Rocco83/esphome-light-controller/hardware/feedback-breakout/README.md

This board has been never produced
Date: 20261022
