Rocco83/esphome-light-controller/hardware/feedback-breakout-smd/jlcpbc-202610/bom.csv

Designator | Footprint | Quantity | Value | LCSC Part #
C1, C10, C11, C12, C13, C14, C15, C16, C2, C3, C4, C5, C6, C7, C8, C9 | 0805 | 16 | 10nF | C1710
D1, D10, D11, D12, D13, D14, D15, D16, D2, D3, D4, D5, D6, D7, D8, D9 | 0805 | 16 | GREEN | C2297
JINA | PinHeader_1x10_P2.54mm_Vertical | 1 | IN-A
JINB | PinHeader_1x10_P2.54mm_Vertical | 1 | IN-B
JOUTA | PinHeader_1x10_P2.54mm_Vertical | 1 | OUT-A
JOUTB | PinHeader_1x10_P2.54mm_Vertical | 1 | OUT-B
Q1, Q10, Q11, Q12, Q13, Q14, Q15, Q16, Q2, Q3, Q4, Q5, Q6, Q7, Q8, Q9 | SOT-23 | 16 | BC817-40 | C8589
R1, R10, R11, R12, R13, R14, R15, R16, R2, R3, R4, R5, R6, R7, R8, R9, RB1, RB10, RB11, RB12, RB13, RB14, RB15, RB16, RB2, RB3, RB4, RB5, RB6, RB7, RB8, RB9 | 0805 | 32 | 100k | C149504
RE1, RE10, RE11, RE12, RE13, RE14, RE15, RE16, RE2, RE3, RE4, RE5, RE6, RE7, RE8, RE9 | 0805 | 16 | 1k | C17513
