Rocco83/esphome-light-controller/hardware/feedback-breakout/feedback-breakout.kicad_pcb

## KiCad design hardware/feedback-breakout/feedback-breakout.kicad_pcb (2026-10-22)

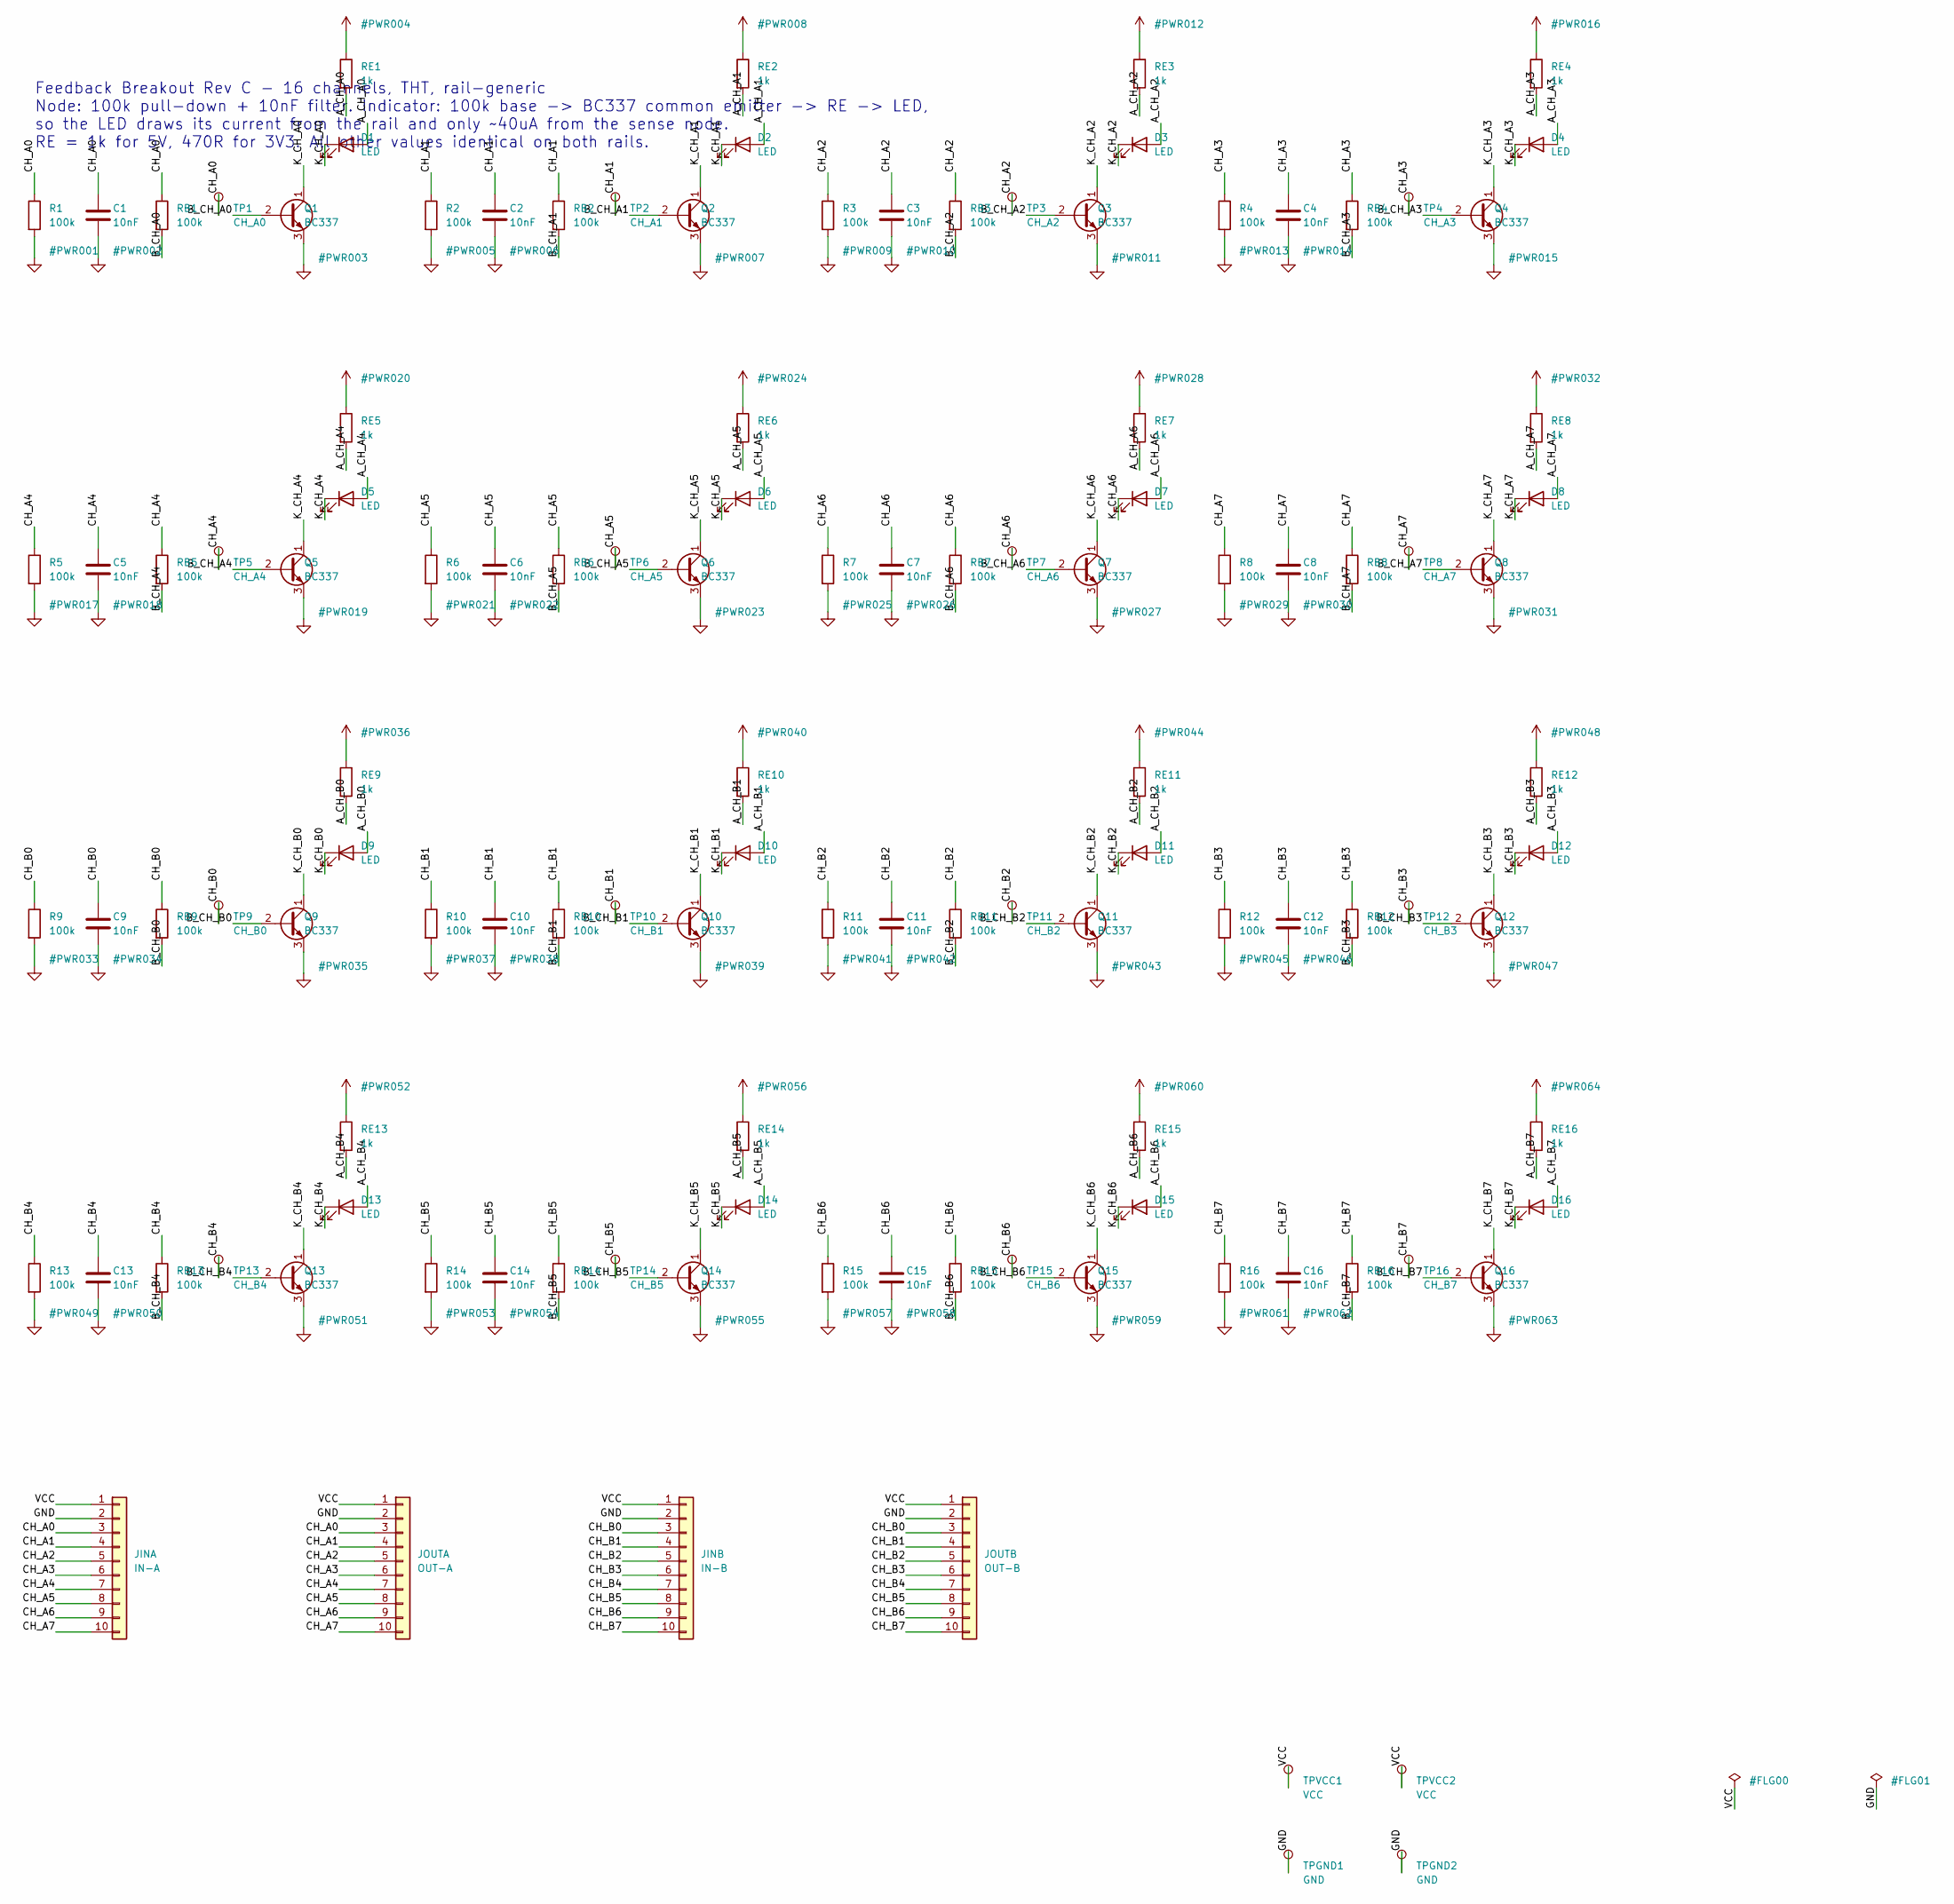
[picture p1: schematic feedback-breakout.kicad_sch, Feedback Breakout Rev C]

Parts:
C1, C2, C3, C4, C5, C6, C7, C8, C9, C10, C11, C12, C13, C14, C15, C16: 10nF; C_Disc_D3.0mm_W1.6mm_P2.50mm
D1, D2, D3, D4, D5, D6, D7, D8, D9, D10, D11, D12, D13, D14, D15, D16: LED; LED_D1.8mm_W3.3mm_H2.4mm
JINA: IN-A; PinHeader_1x10_P2.54mm_Vertical
JINB: IN-B; PinHeader_1x10_P2.54mm_Vertical
JOUTA: OUT-A; PinHeader_1x10_P2.54mm_Vertical
JOUTB: OUT-B; PinHeader_1x10_P2.54mm_Vertical
Q1, Q2, Q3, Q4, Q5, Q6, Q7, Q8, Q9, Q10, Q11, Q12, Q13, Q14, Q15, Q16: BC337; TO-92_Inline
R1, R2, R3, R4, R5, R6, R7, R8, R9, R10, R11, R12, R13, R14, R15, R16: 100k; R_Axial_DIN0204_L3.6mm_D1.6mm_P2.54mm_Vertical
RB1, RB2, RB3, RB4, RB5, RB6, RB7, RB8, RB9, RB10, RB11, RB12, RB13, RB14, RB15, RB16: 100k; R_Axial_DIN0204_L3.6mm_D1.6mm_P2.54mm_Vertical
RE1, RE2, RE3, RE4, RE5, RE6, RE7, RE8, RE9, RE10, RE11, RE12, RE13, RE14, RE15, RE16: 1k; R_Axial_DIN0204_L3.6mm_D1.6mm_P2.54mm_Vertical
TP1: CH_A0; TestPoint_THTPad_D1.5mm_Drill0.7mm
TP2: CH_A1; TestPoint_THTPad_D1.5mm_Drill0.7mm
TP3: CH_A2; TestPoint_THTPad_D1.5mm_Drill0.7mm
TP4: CH_A3; TestPoint_THTPad_D1.5mm_Drill0.7mm
TP5: CH_A4; TestPoint_THTPad_D1.5mm_Drill0.7mm
TP6: CH_A5; TestPoint_THTPad_D1.5mm_Drill0.7mm
TP7: CH_A6; TestPoint_THTPad_D1.5mm_Drill0.7mm
TP8: CH_A7; TestPoint_THTPad_D1.5mm_Drill0.7mm
TP9: CH_B0; TestPoint_THTPad_D1.5mm_Drill0.7mm
TP10: CH_B1; TestPoint_THTPad_D1.5mm_Drill0.7mm
TP11: CH_B2; TestPoint_THTPad_D1.5mm_Drill0.7mm
TP12: CH_B3; TestPoint_THTPad_D1.5mm_Drill0.7mm
TP13: CH_B4; TestPoint_THTPad_D1.5mm_Drill0.7mm
TP14: CH_B5; TestPoint_THTPad_D1.5mm_Drill0.7mm
TP15: CH_B6; TestPoint_THTPad_D1.5mm_Drill0.7mm
TP16: CH_B7; TestPoint_THTPad_D1.5mm_Drill0.7mm
TPGND1, TPGND2: GND; TestPoint_THTPad_D1.5mm_Drill0.7mm
TPVCC1, TPVCC2: VCC; TestPoint_THTPad_D1.5mm_Drill0.7mm

Connections:
A_CH_A0: D1.2 (A), RE1.2
A_CH_A1: D2.2 (A), RE2.2
A_CH_A2: D3.2 (A), RE3.2
A_CH_A3: D4.2 (A), RE4.2
A_CH_A4: D5.2 (A), RE5.2
A_CH_A5: D6.2 (A), RE6.2
A_CH_A6: D7.2 (A), RE7.2
A_CH_A7: D8.2 (A), RE8.2
A_CH_B0: D9.2 (A), RE9.2
A_CH_B1: D10.2 (A), RE10.2
A_CH_B2: D11.2 (A), RE11.2
A_CH_B3: D12.2 (A), RE12.2
A_CH_B4: D13.2 (A), RE13.2
A_CH_B5: D14.2 (A), RE14.2
A_CH_B6: D15.2 (A), RE15.2
A_CH_B7: D16.2 (A), RE16.2
B_CH_A0: Q1.2 (B), RB1.2
B_CH_A1: Q2.2 (B), RB2.2
B_CH_A2: Q3.2 (B), RB3.2
B_CH_A3: Q4.2 (B), RB4.2
B_CH_A4: Q5.2 (B), RB5.2
B_CH_A5: Q6.2 (B), RB6.2
B_CH_A6: Q7.2 (B), RB7.2
B_CH_A7: Q8.2 (B), RB8.2
B_CH_B0: Q9.2 (B), RB9.2
B_CH_B1: Q10.2 (B), RB10.2
B_CH_B2: Q11.2 (B), RB11.2
B_CH_B3: Q12.2 (B), RB12.2
B_CH_B4: Q13.2 (B), RB13.2
B_CH_B5: Q14.2 (B), RB14.2
B_CH_B6: Q15.2 (B), RB15.2
B_CH_B7: Q16.2 (B), RB16.2
CH_A0: C1.1, JINA.3, JOUTA.3, R1.1, RB1.1, TP1.1
CH_A1: C2.1, JINA.4, JOUTA.4, R2.1, RB2.1, TP2.1
CH_A2: C3.1, JINA.5, JOUTA.5, R3.1, RB3.1, TP3.1
CH_A3: C4.1, JINA.6, JOUTA.6, R4.1, RB4.1, TP4.1
CH_A4: C5.1, JINA.7, JOUTA.7, R5.1, RB5.1, TP5.1
CH_A5: C6.1, JINA.8, JOUTA.8, R6.1, RB6.1, TP6.1
CH_A6: C7.1, JINA.9, JOUTA.9, R7.1, RB7.1, TP7.1
CH_A7: C8.1, JINA.10, JOUTA.10, R8.1, RB8.1, TP8.1
CH_B0: C9.1, JINB.3, JOUTB.3, R9.1, RB9.1, TP9.1
CH_B1: C10.1, JINB.4, JOUTB.4, R10.1, RB10.1, TP10.1
CH_B2: C11.1, JINB.5, JOUTB.5, R11.1, RB11.1, TP11.1
CH_B3: C12.1, JINB.6, JOUTB.6, R12.1, RB12.1, TP12.1
CH_B4: C13.1, JINB.7, JOUTB.7, R13.1, RB13.1, TP13.1
CH_B5: C14.1, JINB.8, JOUTB.8, R14.1, RB14.1, TP14.1
CH_B6: C15.1, JINB.9, JOUTB.9, R15.1, RB15.1, TP15.1
CH_B7: C16.1, JINB.10, JOUTB.10, R16.1, RB16.1, TP16.1
GND: C1.2, C2.2, C3.2, C4.2, C5.2, C6.2, C7.2, C8.2, C9.2, C10.2, C11.2, C12.2, C13.2, C14.2, C15.2, C16.2, JINA.2, JINB.2, JOUTA.2, JOUTB.2, Q1.3 (E), Q2.3 (E), Q3.3 (E), Q4.3 (E), Q5.3 (E), Q6.3 (E), Q7.3 (E), Q8.3 (E), Q9.3 (E), Q10.3 (E), Q11.3 (E), Q12.3 (E), Q13.3 (E), Q14.3 (E), Q15.3 (E), Q16.3 (E), R1.2, R2.2, R3.2, R4.2, R5.2, R6.2, R7.2, R8.2, R9.2, R10.2, R11.2, R12.2, R13.2, R14.2, R15.2, R16.2, TPGND1.1, TPGND2.1
K_CH_A0: D1.1 (K), Q1.1 (C)
K_CH_A1: D2.1 (K), Q2.1 (C)
K_CH_A2: D3.1 (K), Q3.1 (C)
K_CH_A3: D4.1 (K), Q4.1 (C)
K_CH_A4: D5.1 (K), Q5.1 (C)
K_CH_A5: D6.1 (K), Q6.1 (C)
K_CH_A6: D7.1 (K), Q7.1 (C)
K_CH_A7: D8.1 (K), Q8.1 (C)
K_CH_B0: D9.1 (K), Q9.1 (C)
K_CH_B1: D10.1 (K), Q10.1 (C)
K_CH_B2: D11.1 (K), Q11.1 (C)
K_CH_B3: D12.1 (K), Q12.1 (C)
K_CH_B4: D13.1 (K), Q13.1 (C)
K_CH_B5: D14.1 (K), Q14.1 (C)
K_CH_B6: D15.1 (K), Q15.1 (C)
K_CH_B7: D16.1 (K), Q16.1 (C)
VCC: JINA.1, JINB.1, JOUTA.1, JOUTB.1, RE1.1, RE2.1, RE3.1, RE4.1, RE5.1, RE6.1, RE7.1, RE8.1, RE9.1, RE10.1, RE11.1, RE12.1, RE13.1, RE14.1, RE15.1, RE16.1, TPVCC1.1, TPVCC2.1

Notes on the sheet:
Feedback Breakout Rev C - 16 channels, THT, rail-generic Node: 100k pull-down + 10nF filter. Indicator: 100k base -> BC337 common emitter -> RE -> LED, so the LED draws its current from the rail and only ~40uA from the sense node. RE = 1k for 5V, 470R for 3V3. All other values identical on both rai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

Board: 2 copper layers, 122 parts (0 on the bottom side), 66 nets, no tracks yet.

Other parts of the board:
H1, H2: M3; MountingHole_3.2mm_M3_DIN965
