Rocco83/esphome-light-controller/hardware/feedback-breakout-5v/feedback-breakout-5v.kicad_pcb

## KiCad design hardware/feedback-breakout-5v/feedback-breakout-5v.kicad_pcb (2026-09-16)

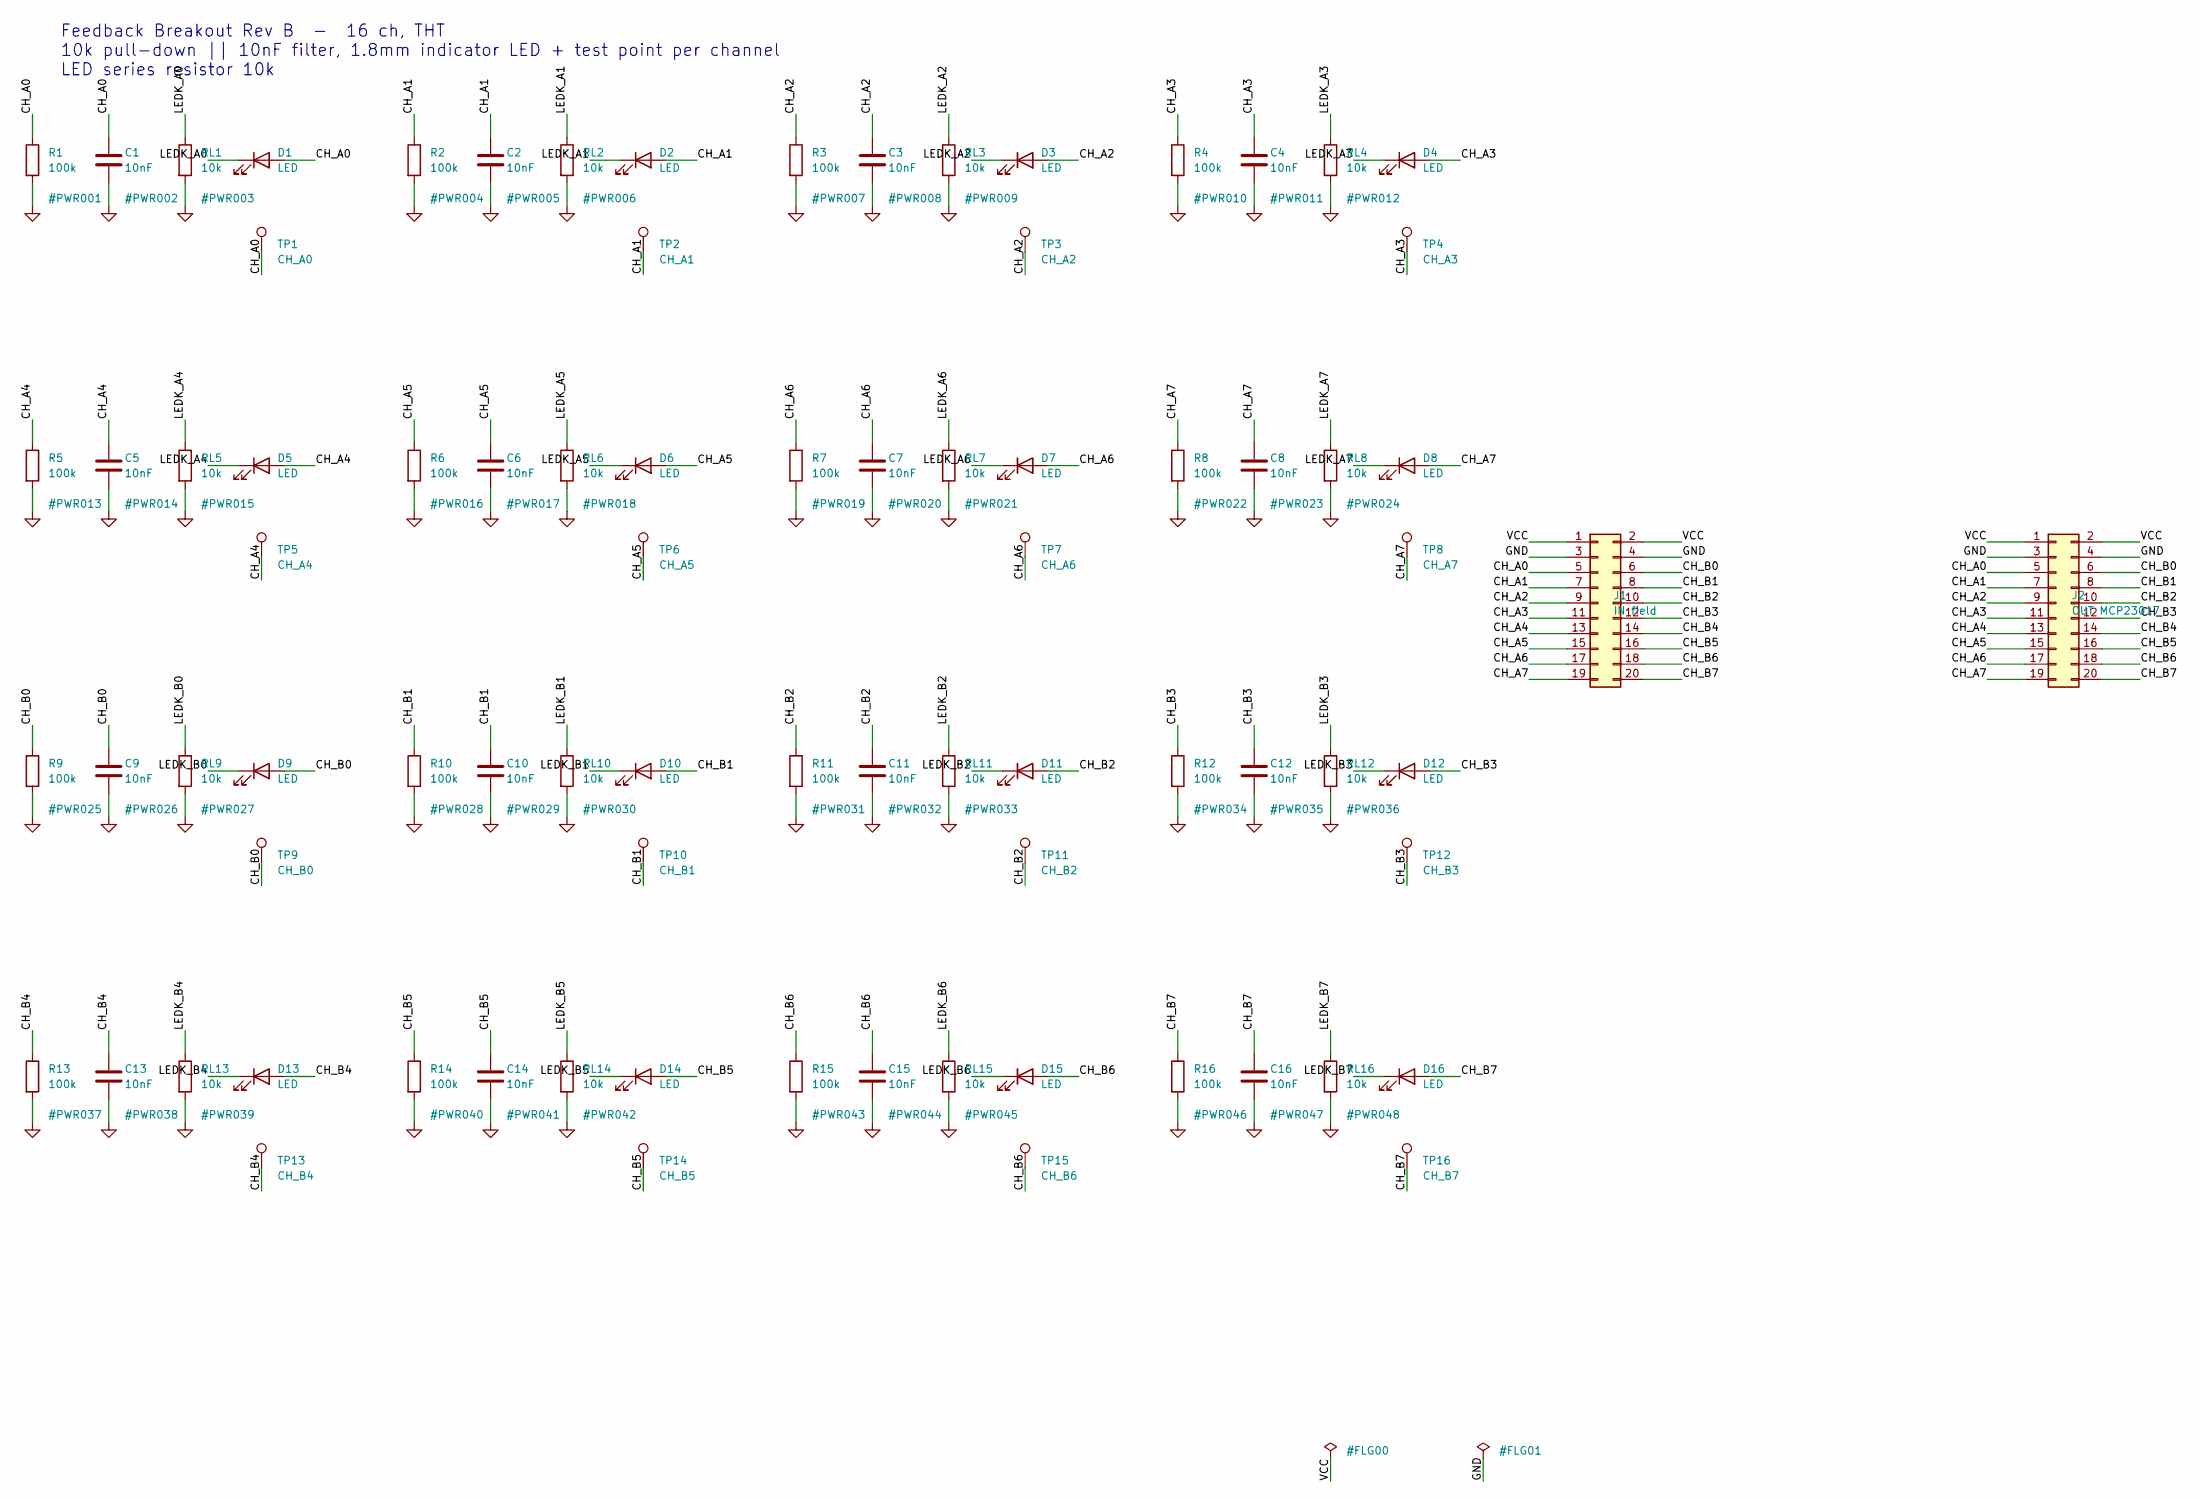
[picture p2: schematic feedback-breakout-5v.kicad_sch, Feedback Breakout Rev B]

Parts:
C1, C2, C3, C4, C5, C6, C7, C8, C9, C10, C11, C12, C13, C14, C15, C16: 10nF; C_Disc_D3.0mm_W1.6mm_P2.50mm
D1, D2, D3, D4, D5, D6, D7, D8, D9, D10, D11, D12, D13, D14, D15, D16: LED; LED_D1.8mm_W3.3mm_H2.4mm
J1: IN field; PinHeader_2x10_P2.54mm_Vertical
J2: OUT MCP23017; PinHeader_2x10_P2.54mm_Vertical
R1, R2, R3, R4, R5, R6, R7, R8, R9, R10, R11, R12, R13, R14, R15, R16: 100k; R_Axial_DIN0204_L3.6mm_D1.6mm_P2.54mm_Vertical
RL1, RL2, RL3, RL4, RL5, RL6, RL7, RL8, RL9, RL10, RL11, RL12, RL13, RL14, RL15, RL16: 10k; R_Axial_DIN0204_L3.6mm_D1.6mm_P2.54mm_Vertical
TP1: CH_A0; TestPoint_Pad_1.0x1.0mm
TP2: CH_A1; TestPoint_Pad_1.0x1.0mm
TP3: CH_A2; TestPoint_Pad_1.0x1.0mm
TP4: CH_A3; TestPoint_Pad_1.0x1.0mm
TP5: CH_A4; TestPoint_Pad_1.0x1.0mm
TP6: CH_A5; TestPoint_Pad_1.0x1.0mm
TP7: CH_A6; TestPoint_Pad_1.0x1.0mm
TP8: CH_A7; TestPoint_Pad_1.0x1.0mm
TP9: CH_B0; TestPoint_Pad_1.0x1.0mm
TP10: CH_B1; TestPoint_Pad_1.0x1.0mm
TP11: CH_B2; TestPoint_Pad_1.0x1.0mm
TP12: CH_B3; TestPoint_Pad_1.0x1.0mm
TP13: CH_B4; TestPoint_Pad_1.0x1.0mm
TP14: CH_B5; TestPoint_Pad_1.0x1.0mm
TP15: CH_B6; TestPoint_Pad_1.0x1.0mm
TP16: CH_B7; TestPoint_Pad_1.0x1.0mm

Connections:
CH_A0: C1.1, D1.2 (A), J1.5, J2.5, R1.1, TP1.1
CH_A1: C2.1, D2.2 (A), J1.7, J2.7, R2.1, TP2.1
CH_A2: C3.1, D3.2 (A), J1.9, J2.9, R3.1, TP3.1
CH_A3: C4.1, D4.2 (A), J1.11, J2.11, R4.1, TP4.1
CH_A4: C5.1, D5.2 (A), J1.13, J2.13, R5.1, TP5.1
CH_A5: C6.1, D6.2 (A), J1.15, J2.15, R6.1, TP6.1
CH_A6: C7.1, D7.2 (A), J1.17, J2.17, R7.1, TP7.1
CH_A7: C8.1, D8.2 (A), J1.19, J2.19, R8.1, TP8.1
CH_B0: C9.1, D9.2 (A), J1.6, J2.6, R9.1, TP9.1
CH_B1: C10.1, D10.2 (A), J1.8, J2.8, R10.1, TP10.1
CH_B2: C11.1, D11.2 (A), J1.10, J2.10, R11.1, TP11.1
CH_B3: C12.1, D12.2 (A), J1.12, J2.12, R12.1, TP12.1
CH_B4: C13.1, D13.2 (A), J1.14, J2.14, R13.1, TP13.1
CH_B5: C14.1, D14.2 (A), J1.16, J2.16, R14.1, TP14.1
CH_B6: C15.1, D15.2 (A), J1.18, J2.18, R15.1, TP15.1
CH_B7: C16.1, D16.2 (A), J1.20, J2.20, R16.1, TP16.1
GND: C1.2, C2.2, C3.2, C4.2, C5.2, C6.2, C7.2, C8.2, C9.2, C10.2, C11.2, C12.2, C13.2, C14.2, C15.2, C16.2, J1.3, J1.4, J2.3, J2.4, R1.2, R2.2, R3.2, R4.2, R5.2, R6.2, R7.2, R8.2, R9.2, R10.2, R11.2, R12.2, R13.2, R14.2, R15.2, R16.2, RL1.2, RL2.2, RL3.2, RL4.2, RL5.2, RL6.2, RL7.2, RL8.2, RL9.2, RL10.2, RL11.2, RL12.2, RL13.2, RL14.2, RL15.2, RL16.2
LEDK_A0: D1.1 (K), RL1.1
LEDK_A1: D2.1 (K), RL2.1
LEDK_A2: D3.1 (K), RL3.1
LEDK_A3: D4.1 (K), RL4.1
LEDK_A4: D5.1 (K), RL5.1
LEDK_A5: D6.1 (K), RL6.1
LEDK_A6: D7.1 (K), RL7.1
LEDK_A7: D8.1 (K), RL8.1
LEDK_B0: D9.1 (K), RL9.1
LEDK_B1: D10.1 (K), RL10.1
LEDK_B2: D11.1 (K), RL11.1
LEDK_B3: D12.1 (K), RL12.1
LEDK_B4: D13.1 (K), RL13.1
LEDK_B5: D14.1 (K), RL14.1
LEDK_B6: D15.1 (K), RL15.1
LEDK_B7: D16.1 (K), RL16.1
VCC: J1.1, J1.2, J2.1, J2.2

Notes on the sheet:
Feedback Breakout Rev B - 16 ch, THT 10k pull-down || 10nF filter, 1.8mm indicator LED + test point per channel LED series resistor 10k

Board: 2 copper layers, 84 parts (0 on the bottom side), 34 nets, no tracks yet.

Other parts of the board:
H1, H2: M3; MountingHole_3.2mm_M3_DIN965
