Rocco83/esphome-light-controller/(commit log)

2026-01-03 Still broken, added lambda, several modifications
    [light-controller.yaml]
2026-01-07 prod v0.1
    - fixed the logic of the read using a script
    - added the safe mode
    - bah, too many other things
    - still broken code
    [light-controller.yaml]
2026-01-07 0.3
    - fixed inverted output (relay when to gnd -> on)
    - fixed back the i2c bus to 400kHz
    - fixed the code to fallback the state of the light to the real state provided by the input
    [light-controller.yaml]
2026-01-07 fixed logic that sync web, added debug
    [light-controller.yaml]
2026-01-08 changed hw to i2c_state, changed to debug 10s logs
    [light-controller.yaml]
2026-02-08 Prod v1
    - Reduced the frequency of the debug logs
    - added i2c logs
    - added the PULLUP to the configuration
    - require now the resistance+capacity to manage the long line
    [light-controller.yaml]
2026-08-31 Switch P1 inputs from INPUT_PULLUP to INPUT, silence interrupt-fallback notice, fix chip-rev warning
    P1's MCP23017 input expander (0x23) has storm-damaged GPPU register —
    confirmed dead via both a forced register write and a full PoE power
    cycle, neither of which restored it. P0 and P1 share identical
    external pull resistor/filter hardware, and P0 already reads correctly
    on plain INPUT, so switch P1's 15 input pins from INPUT_PULLUP to
    INPUT to stop depending on the dead internal pull-up.
    Also:
    - Add use_interrupt: false to all MCP23017-backed binary_sensors,
    since none of them can use a real ISR anyway (expander pins aren't
    internal GPIOs) — silences the compile-time notice, no beh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
2026-09-15 Add CLAUDE.md
    Documents the board's MCP23017 topology, the pulse/impulse-relay output
    logic, the dual feedback-sync mechanism, and common commands for future
    Claude Code sessions working in this repo.
    Claude-Session: https://claude.ai/code/session_013ERnsPGwMJqP29WyuJ45Fs
2026-09-16 Remove dead code and fix misleading log text
    - Drop the leftover duplicate digital_read()/publish_state() call in the
    P0 read loop. Traced via git blame/show to commit 34cf075 ("0.3"),
    which added the force-sync feature by replacing the old single-line
    P1 loop body but only appending to P0's, leaving the original line
    behind unused. Not a deliberate failsafe.
    - Fix copy-pasted log text that printed "i2c_state=1" in the branch
    that forces a light OFF, where i2c_state is actually 0, on both
    floors.
    - Translate the last remaining Italian log/comment text (I2C presence
    check log strings, on_boot priority comment).
    - Remove the on_boot bootcheck block that's been fully commented out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
2026-09-16 Add KiCad project for the 16-channel feedback breakout board
    Manufactured replacement for the hand-soldered perfboard between the
    H11AA1 optoisolator boards and the MCP23017 expanders. 80x20 mm, 2 layer,
    through-hole, M3 holes 68.58 mm apart. Per channel: 100k pull-down,
    10nF line filter, 1.8mm indicator LED with 10k series resistor, and a
    test pad.
    The pull-down is 100k rather than 10k because the opto board already
    provides a 10k one: in parallel they halve to 5k, and the H11AA1 output
    is an emitter follower limited by LED drive x CTR, not a stiff voltage
    source. Values read from the Eagle project give 3.24 mA through the opto
    LED and 0.65 mA worst-case collector current at the 20% minimu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
